g200kg/multiribbon/README.md

# multiribbon

## 開発中

現在開発中の謎楽器です。

複数のリボンコントローラーを並列に並べたフレットレスなギターのような演奏を想定しています。

MCU として XIAO RA4M1 を使用
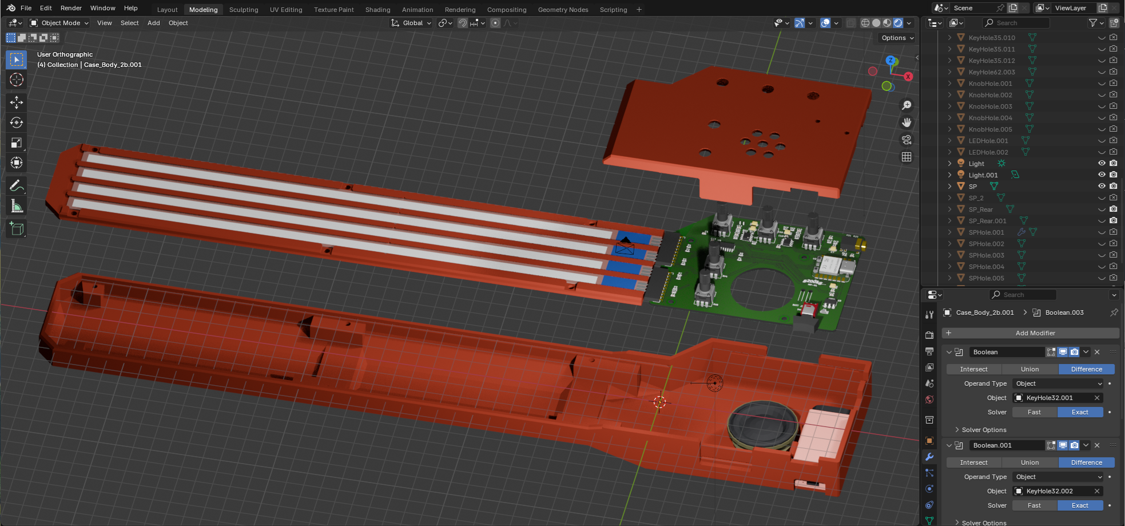
[picture p1: images/20250523_multiribbon_1.png]


## Demo
(https://www.youtube.com/watch?v=zGtmaKtH2Xs)
