g200kg/multiribbon/PCB/PCB-JLCPCB-BOM-Top.xlsx

Comment | Designator | Footprint | JLCPCB Part# | MFR.Part# | Qty
B5819W | D1 | D_SOD-123 | C8598 | B5819W SL | 1
0.1uF | C3,C6,C1,C15,C2,C5,C9,C13 | C_0603_1608Metric | C14663 | CC0603KRX7R9BB104 | 8
10K | R4,R6,R8,R10,R17,R16 | R_0603_1608Metric | C25804 | 0603WAF1002T5E | 6
220R | R3,R5,R7,R9,R20,R21,R18 | R_0603_1608Metric | C22962 | 0603WAF2200T5E | 7
4.7K | R13,R12,R15 | R_0603_1608Metric | C23162 | 0603WAF4701T5E | 3
BLM18AG121SN1D | FB2,FB1 | L_0603_1608Metric | C1002 | GZ1608D601TF | 2
220pF | C18,C17 | C_0603_1608Metric | C1603 | CL10B221KB8NNNC | 2
PAM8302AAD | U5 | SOIC-8_3.9x4.9mm_P1.27mm | C112137 | PAM8302AADCR | 1
10nF | C12 | C_0603_1608Metric | C57112 | 0603B103K500NT | 1
6.8K | R14 | R_0603_1608Metric | C23212 | 0603WAF6801T5E | 1
10uF | C11,C8,C7,C16,C14 | CP_EIA-3216-18_Kemet-A | C7171 | TAJA106K016RNJ | 5
20k | R11 | R_0603_1608Metric | C4184 | 0603WAF2002T5E | 1
2.2K | R2,R1 | R_0603_1608Metric | C4190 | 0603WAF2201T5E | 2
CD74HC4051M96 | U4 | SO-16_3.9x9.9mm_P1.27mm | C132065 | CD74HC4051M96 | 1
XKB_PJ-342B | J5 | Jack_3.5mm_XKB_PJ342B-TX | C388632 | PJ-342B-TX-SMT | 1
LM358DR2G | U1 | SOIC-8_3.9x4.9mm_P1.27mm | C7950 | LM358DR2G | 1
47K | R19,R22 | R_0603_1608Metric | C25819 | 0603WAF4702T5E | 2
2.2nF | C4,C10 | C_0603_1608Metric | C1604 | 0603B222K500NT | 2
AMS1117-5.0 | U3 | SOT-223-3_TabPin2 | C6187 | AMS1117-5.0 | 1
