g200kg/multiribbon/PCB/PCB_Keys/PCB_Keys-JLCPCB-BOM-Top.xlsx

Comment | Designator | Footprint | JLCPCB Part# | MFR.Part# | Qty
SW_Push | SW30,SW27,SW42,SW4,SW28,SW22,SW3,SW38,SW13,SW55,SW11,SW33,SW26,SW40,SW36,SW21,SW35,SW48,SW6,SW20,SW49,SW31,SW14,SW25,SW29,SW16,SW39,SW58,SW44,SW17,SW23,SW12,SW59,SW32,SW10,SW54,SW37,SW18,SW7,SW43,SW15,SW50,SW8,SW19,SW9,SW24,SW47,SW41,SW2,SW5,SW60,SW52,SW56,SW45,SW1,SW34,SW53,SW57,SW46,SW51 | Sw_Push_12x12_SMD | C36498966 | HX 12x12x7.3TPFT-B | 60
1K | R11,R49,R20,R19,R56,R9,R40,R51,R1,R7,R29,R23,R42,R41,R33,R44,R46,R24,R55,R37,R48,R3,R5,R38,R52,R13,R6,R32,R17,R14,R30,R34,R45,R2,R53,R12,R10,R31,R21,R8,R22,R47,R15,R27,R50,R18,R36,R26,R25,R28,R35,R39,R4,R43,R16,R54 | R_0603_1608Metric | C21190 | 0603WAF1001T5E | 56
10K | R58,R60,R59,R57,R65 | R_0603_1608Metric | C25804 | 0603WAF1002T5E | 5
220R | R64,R63,R61,R62 | R_0603_1608Metric | C22962 | 0603WAF2200T5E | 4
0.1uF | C2,C1 | C_0603_1608Metric | C14663 | CC0603KRX7R9BB104 | 2
MMA8452Q | U1 | QFN16_3x3mm_MMA8452Q | C11360 | MMA8452QR1 | 1
