g200kg/multiribbon/Blender/Case_2t.stl

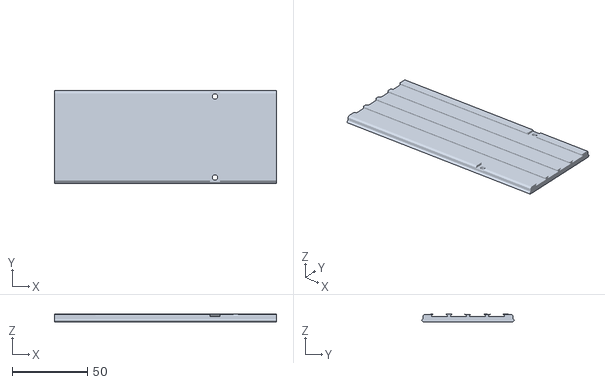
[picture p2: CAD file, 2025-05-23]
Blender/Case_2t.stl
148.0 x 62.0 x 5.00
