g200kg/multiribbon/Blender/Case_2m.stl

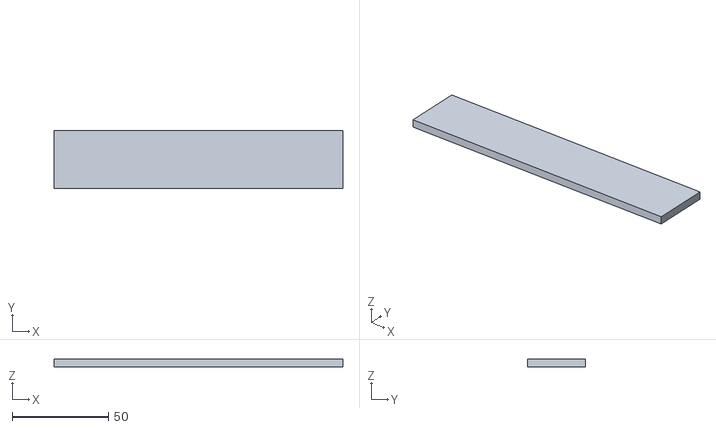
[picture p3: CAD file, 2025-05-23]
Blender/Case_2m.stl
150.0 x 30.0 x 4.00
