g200kg/multiribbon/Blender/Case_3t.stl

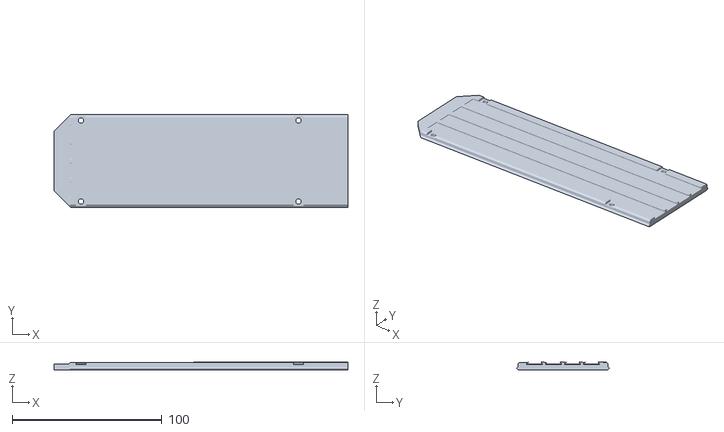
[picture p4: CAD file, 2025-05-23]
Blender/Case_3t.stl
196.0 x 62.0 x 5.00
