g200kg/multiribbon/Blender/Case_1b.stl

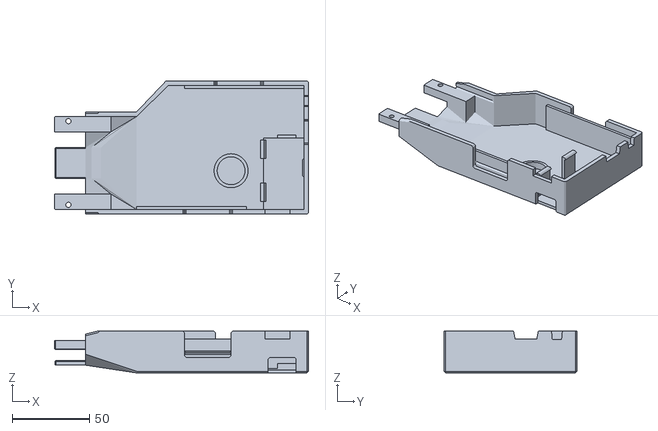
[picture p5: CAD file, 2025-05-23]
Blender/Case_1b.stl
164.0 x 86.0 x 27.0
