g200kg/multiribbon/Blender/Case_2b.stl

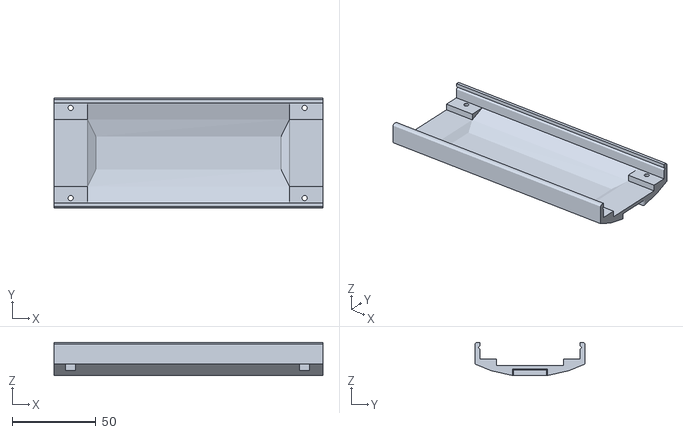
[picture p6: CAD file, 2025-05-18]
Blender/Case_2b.stl
161.0 x 66.0 x 20.0
