g200kg/multiribbon/Blender/Case_1t.stl

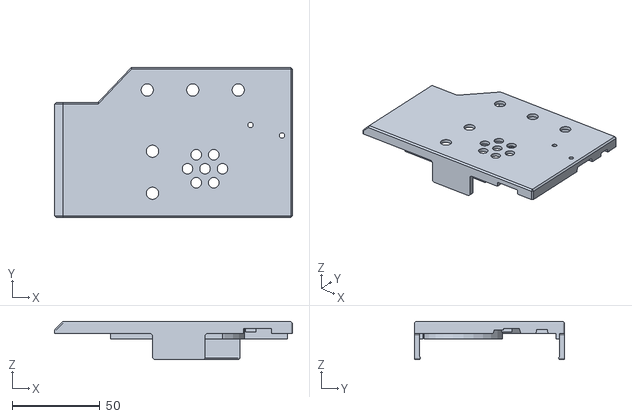
[picture p7: CAD file, 2025-05-18]
Blender/Case_1t.stl
136.0 x 86.0 x 22.0
