g200kg/multiribbon/Blender/Case_3b.stl

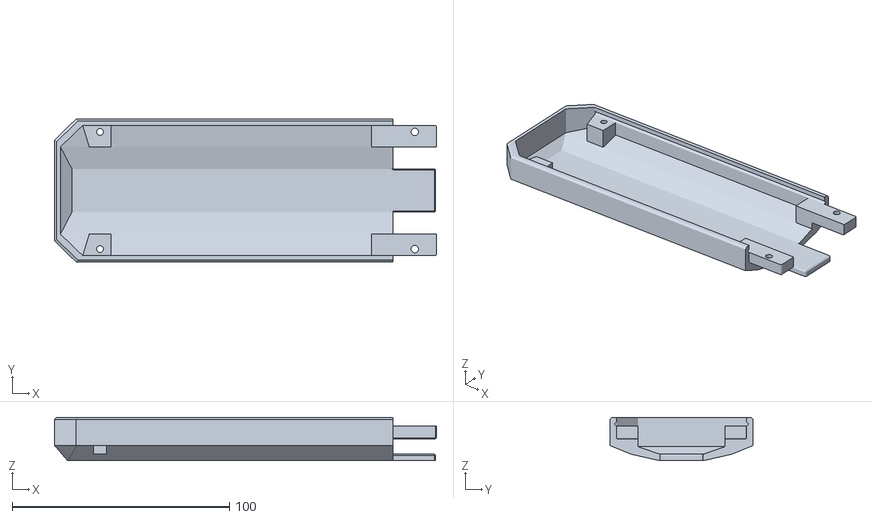
[picture p8: CAD file, 2025-05-18]
Blender/Case_3b.stl
176.0 x 66.0 x 20.0
