g200kg/multiribbon/Docs/XIAO-RA4M1_SCH_PDF_v1.0_240719.pdf

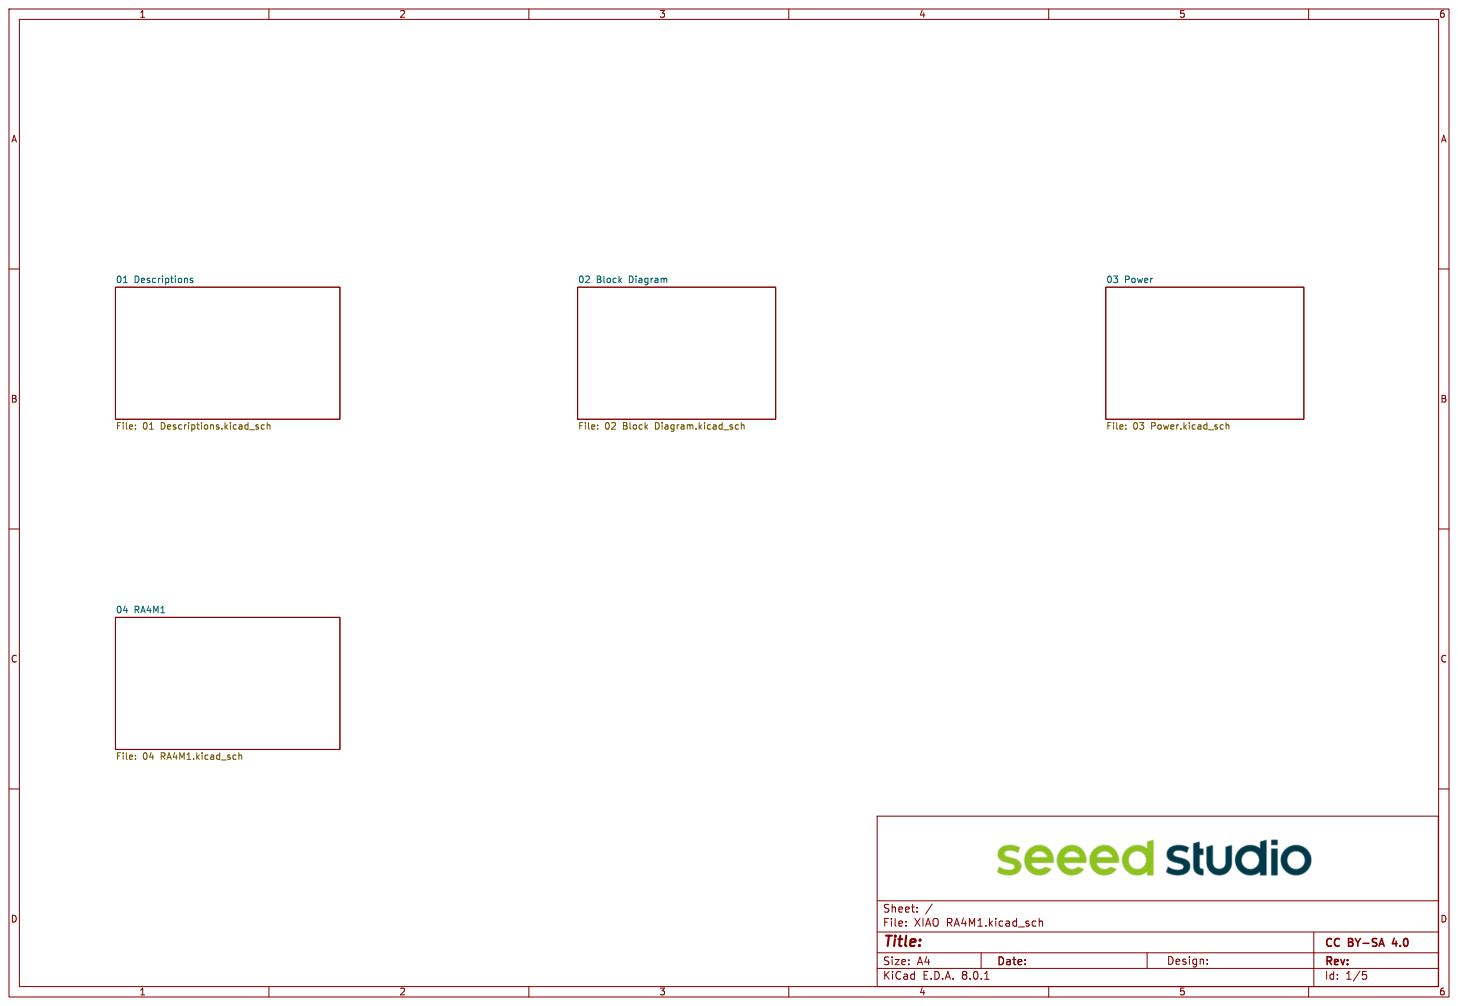
[picture p9: page 1]

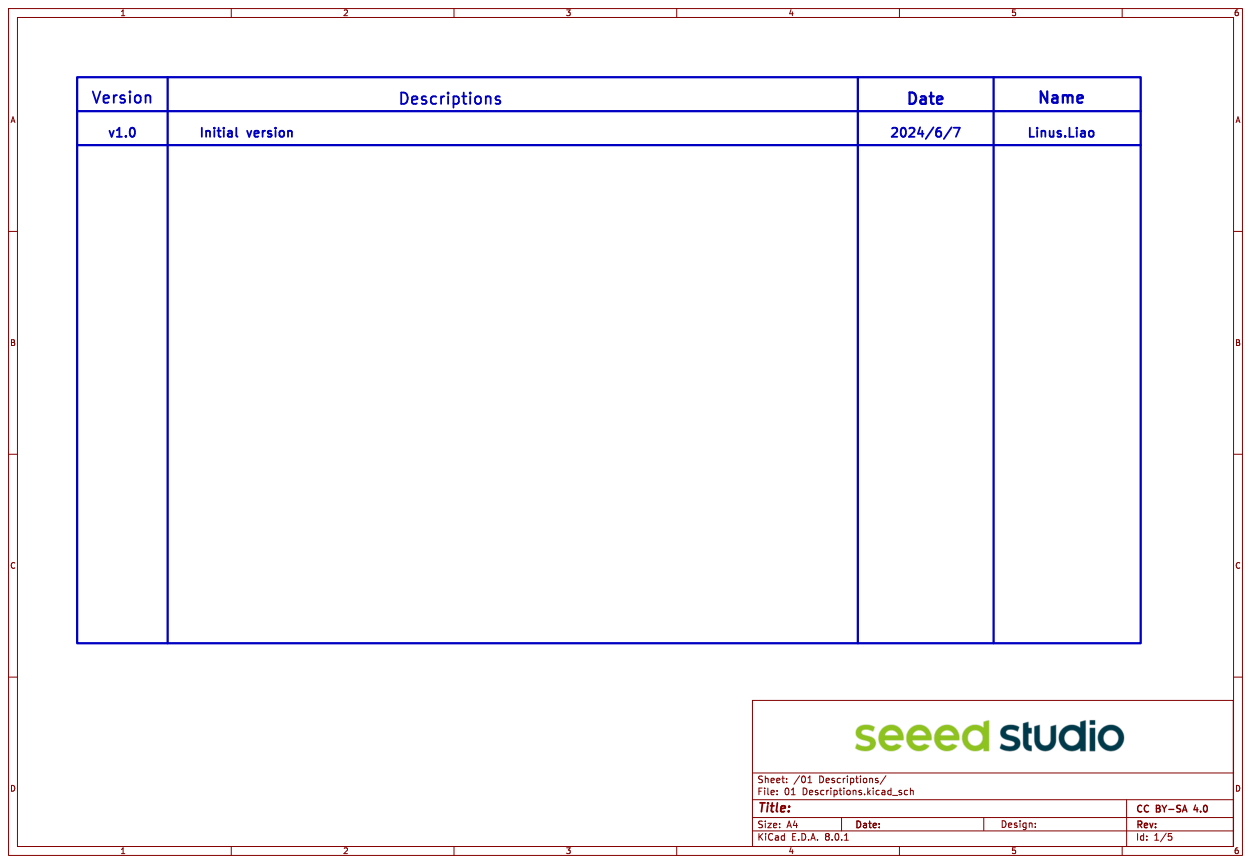
[picture p10: page 2]

Name

2024/6/7 | Linus.Liao

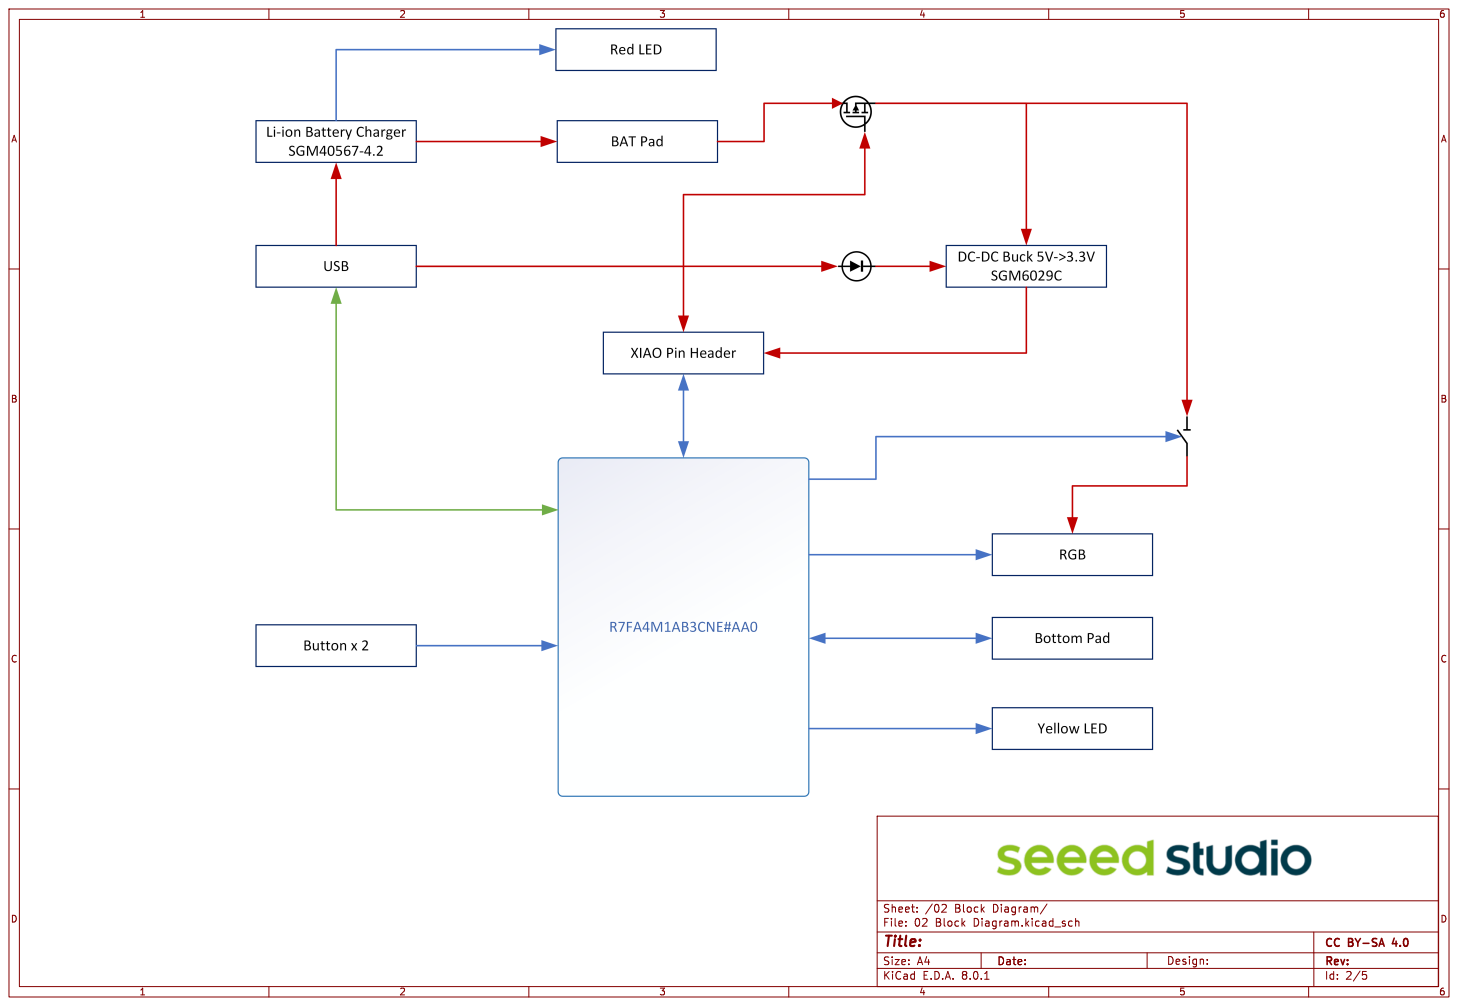
[picture p11: page 3]

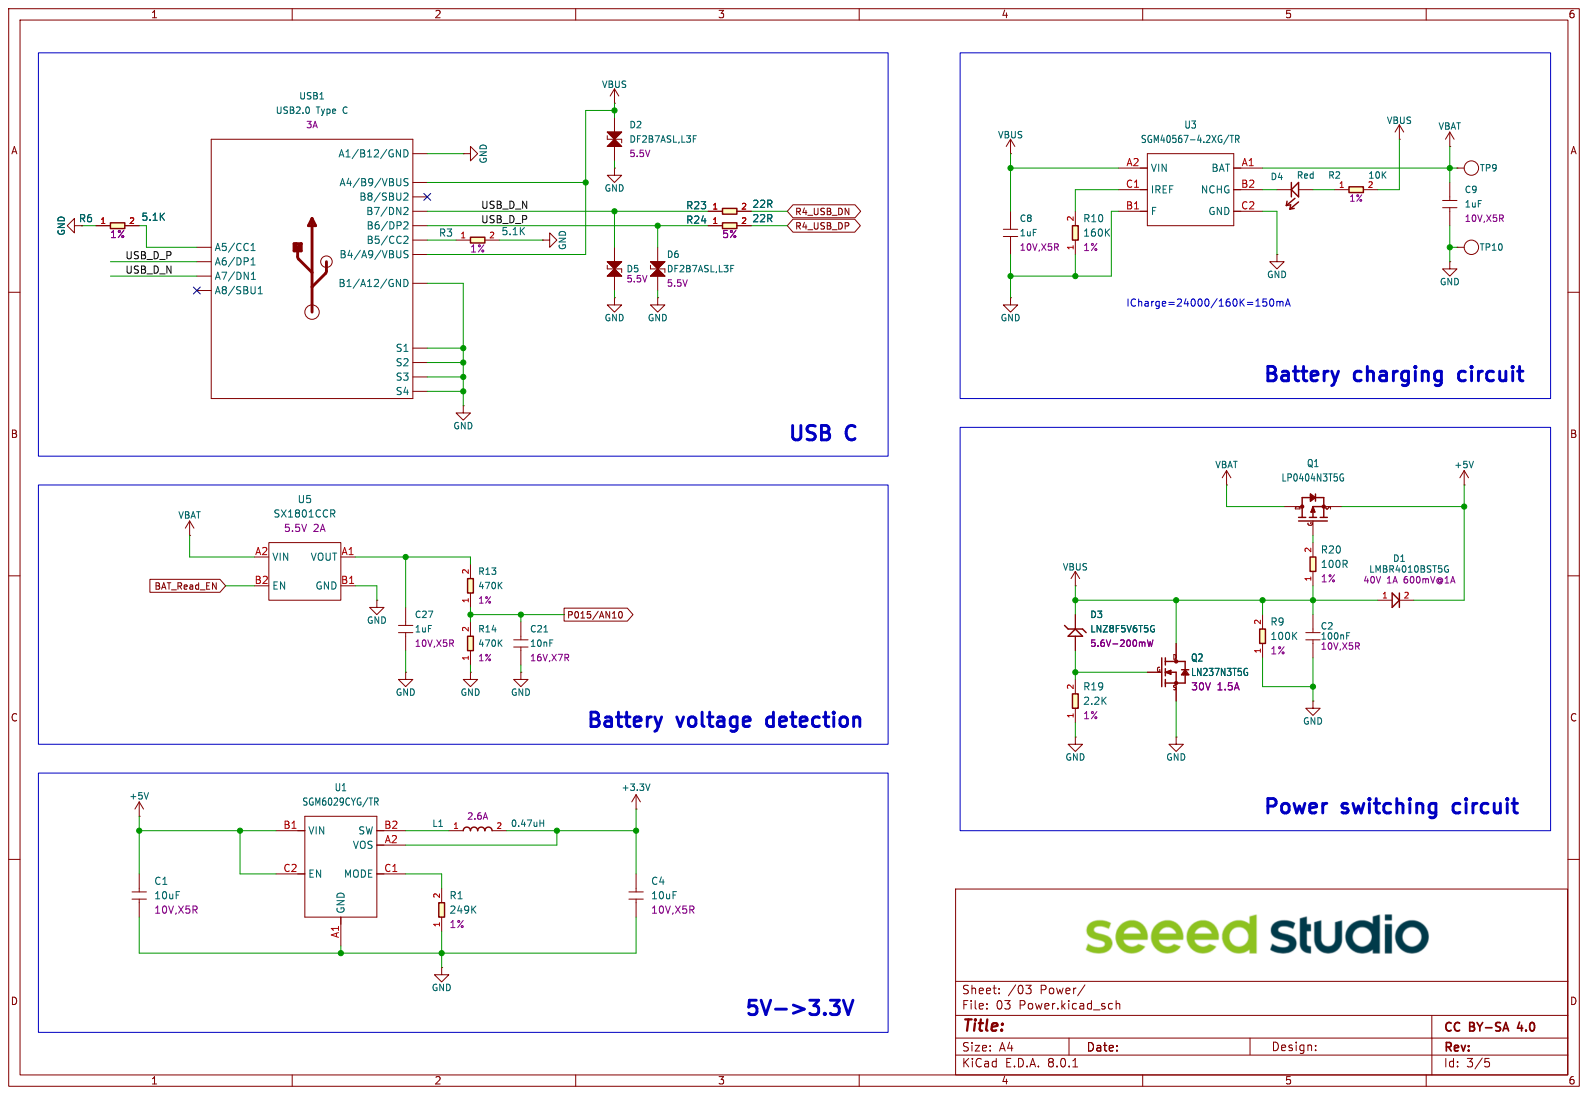
[picture p12: page 4]

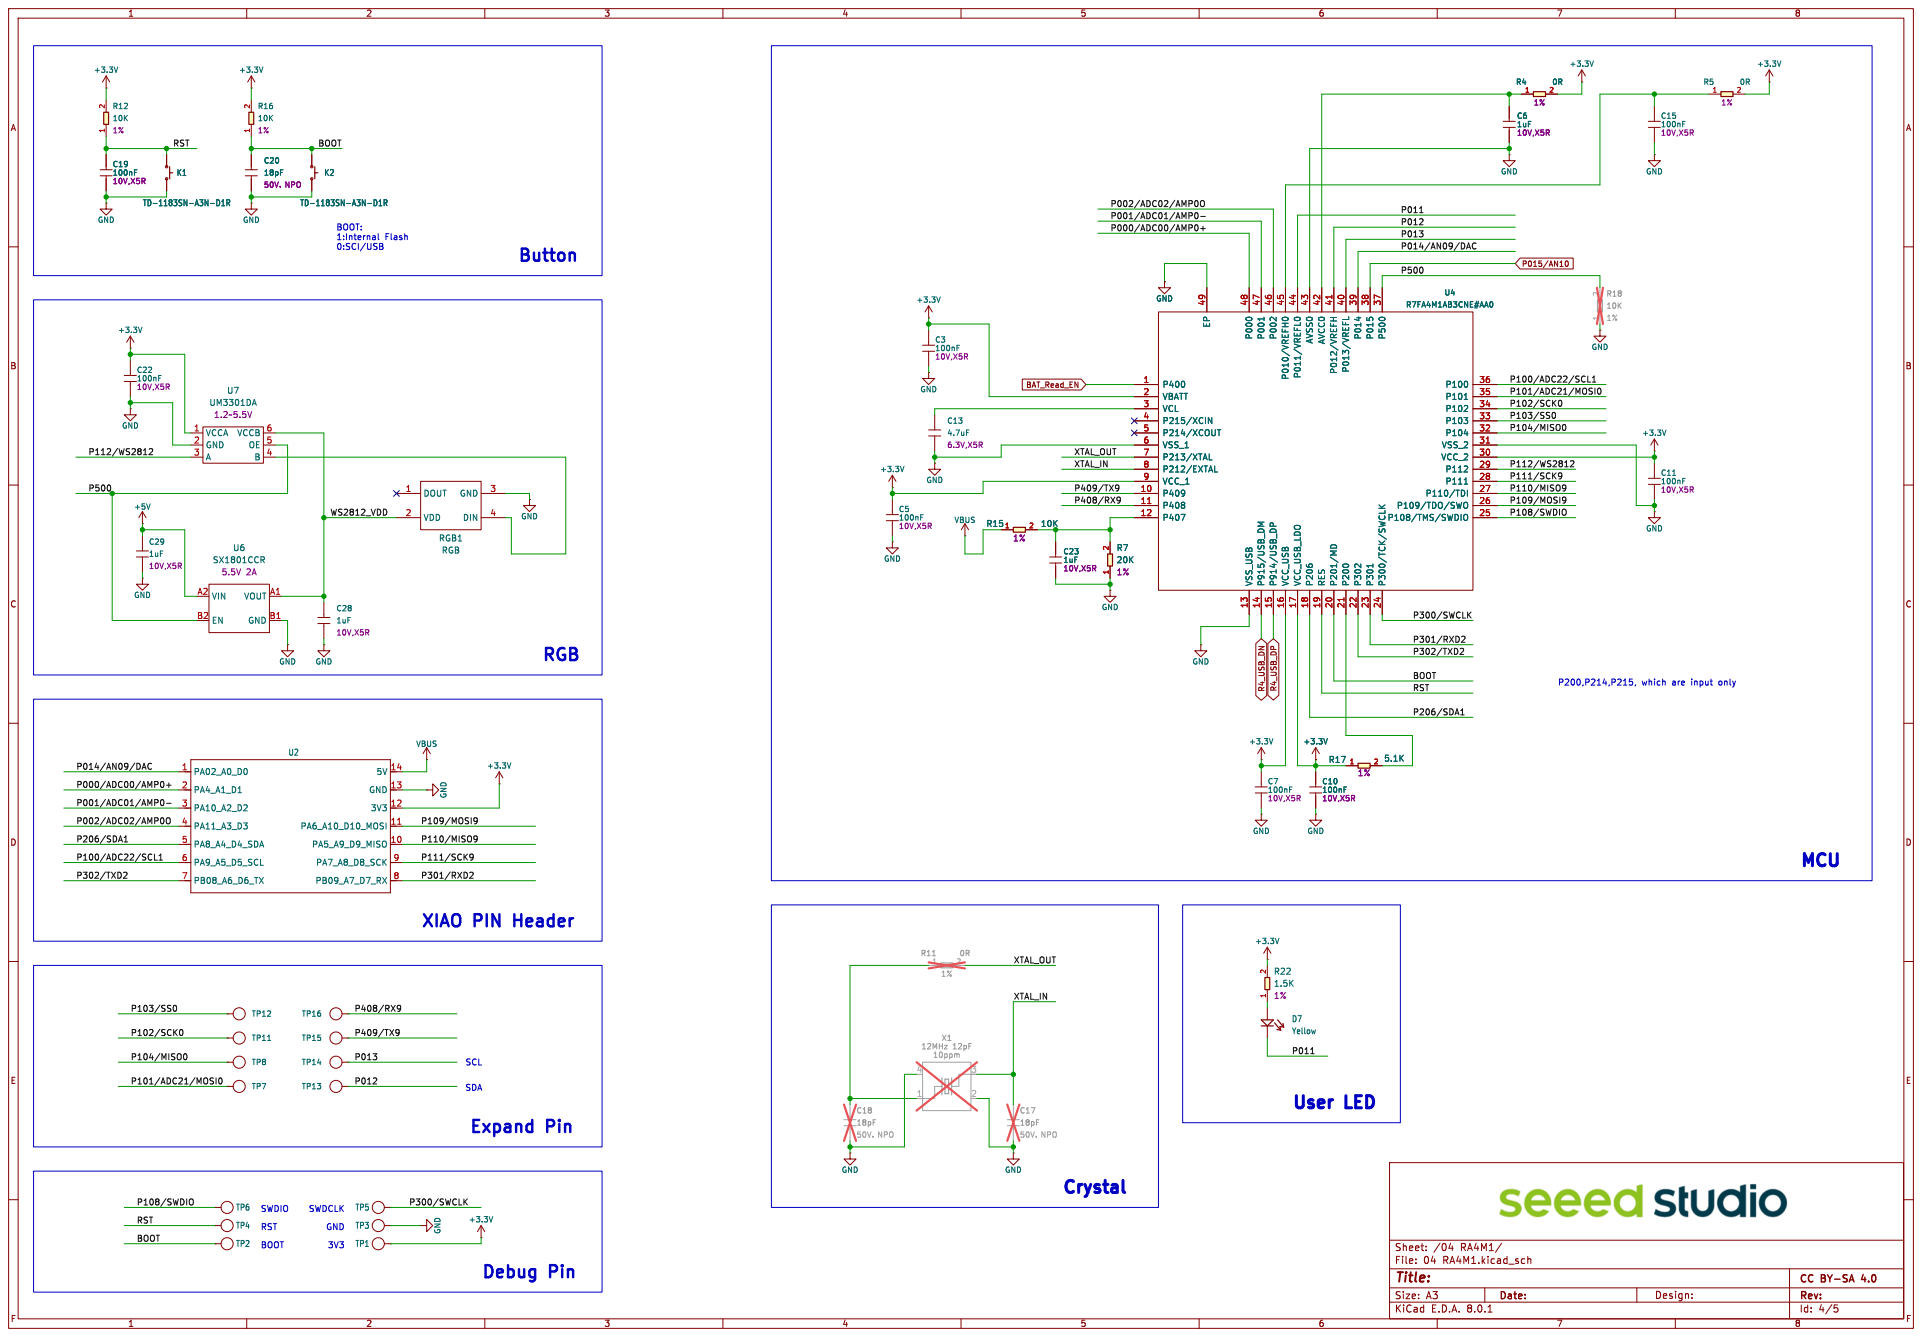
[picture p13: page 5]

2 U4 R7FA4M1AB3CNE#AA0 P400 1 P409 10 P408 11 P407 12 VSS_USB 13 P915/USB_DM 14 P914/USB_DP 15 VCC_USB 16 VCC_USB_LDO 17 P206 18 RES 19 VBATT 2 P201/MD 20 P200 21 P302 22 P301 23 P300/TCK/SWCLK 24 P108/TMS/SWDIO 25 P109/TDO/SWO 26 P110/TDI 27 P111 28 P112 29 VCL 3 VCC_2 30 VSS_2 31 P104 32 P103 33 P102 34 P101 35 P100 36 P500 37 P015 38 P014 39 P215/XCIN 4 P013/VREFL 40 P012/VREFH 41 AVCC0 42 AVSS0 43 P011/VREFL0 44 P010/VREFH0 45 P002 46 P001 47 P000 48 EP 49 P214/XCOUT 5 VSS_1 6 P213/XTAL 7 P212/EXTAL 8 VCC_1 9 R17 5.1K
