g200kg/multiribbon/PCB/PCB.kicad_pcb

## KiCad design PCB/PCB.kicad_pcb (2025-05-23)

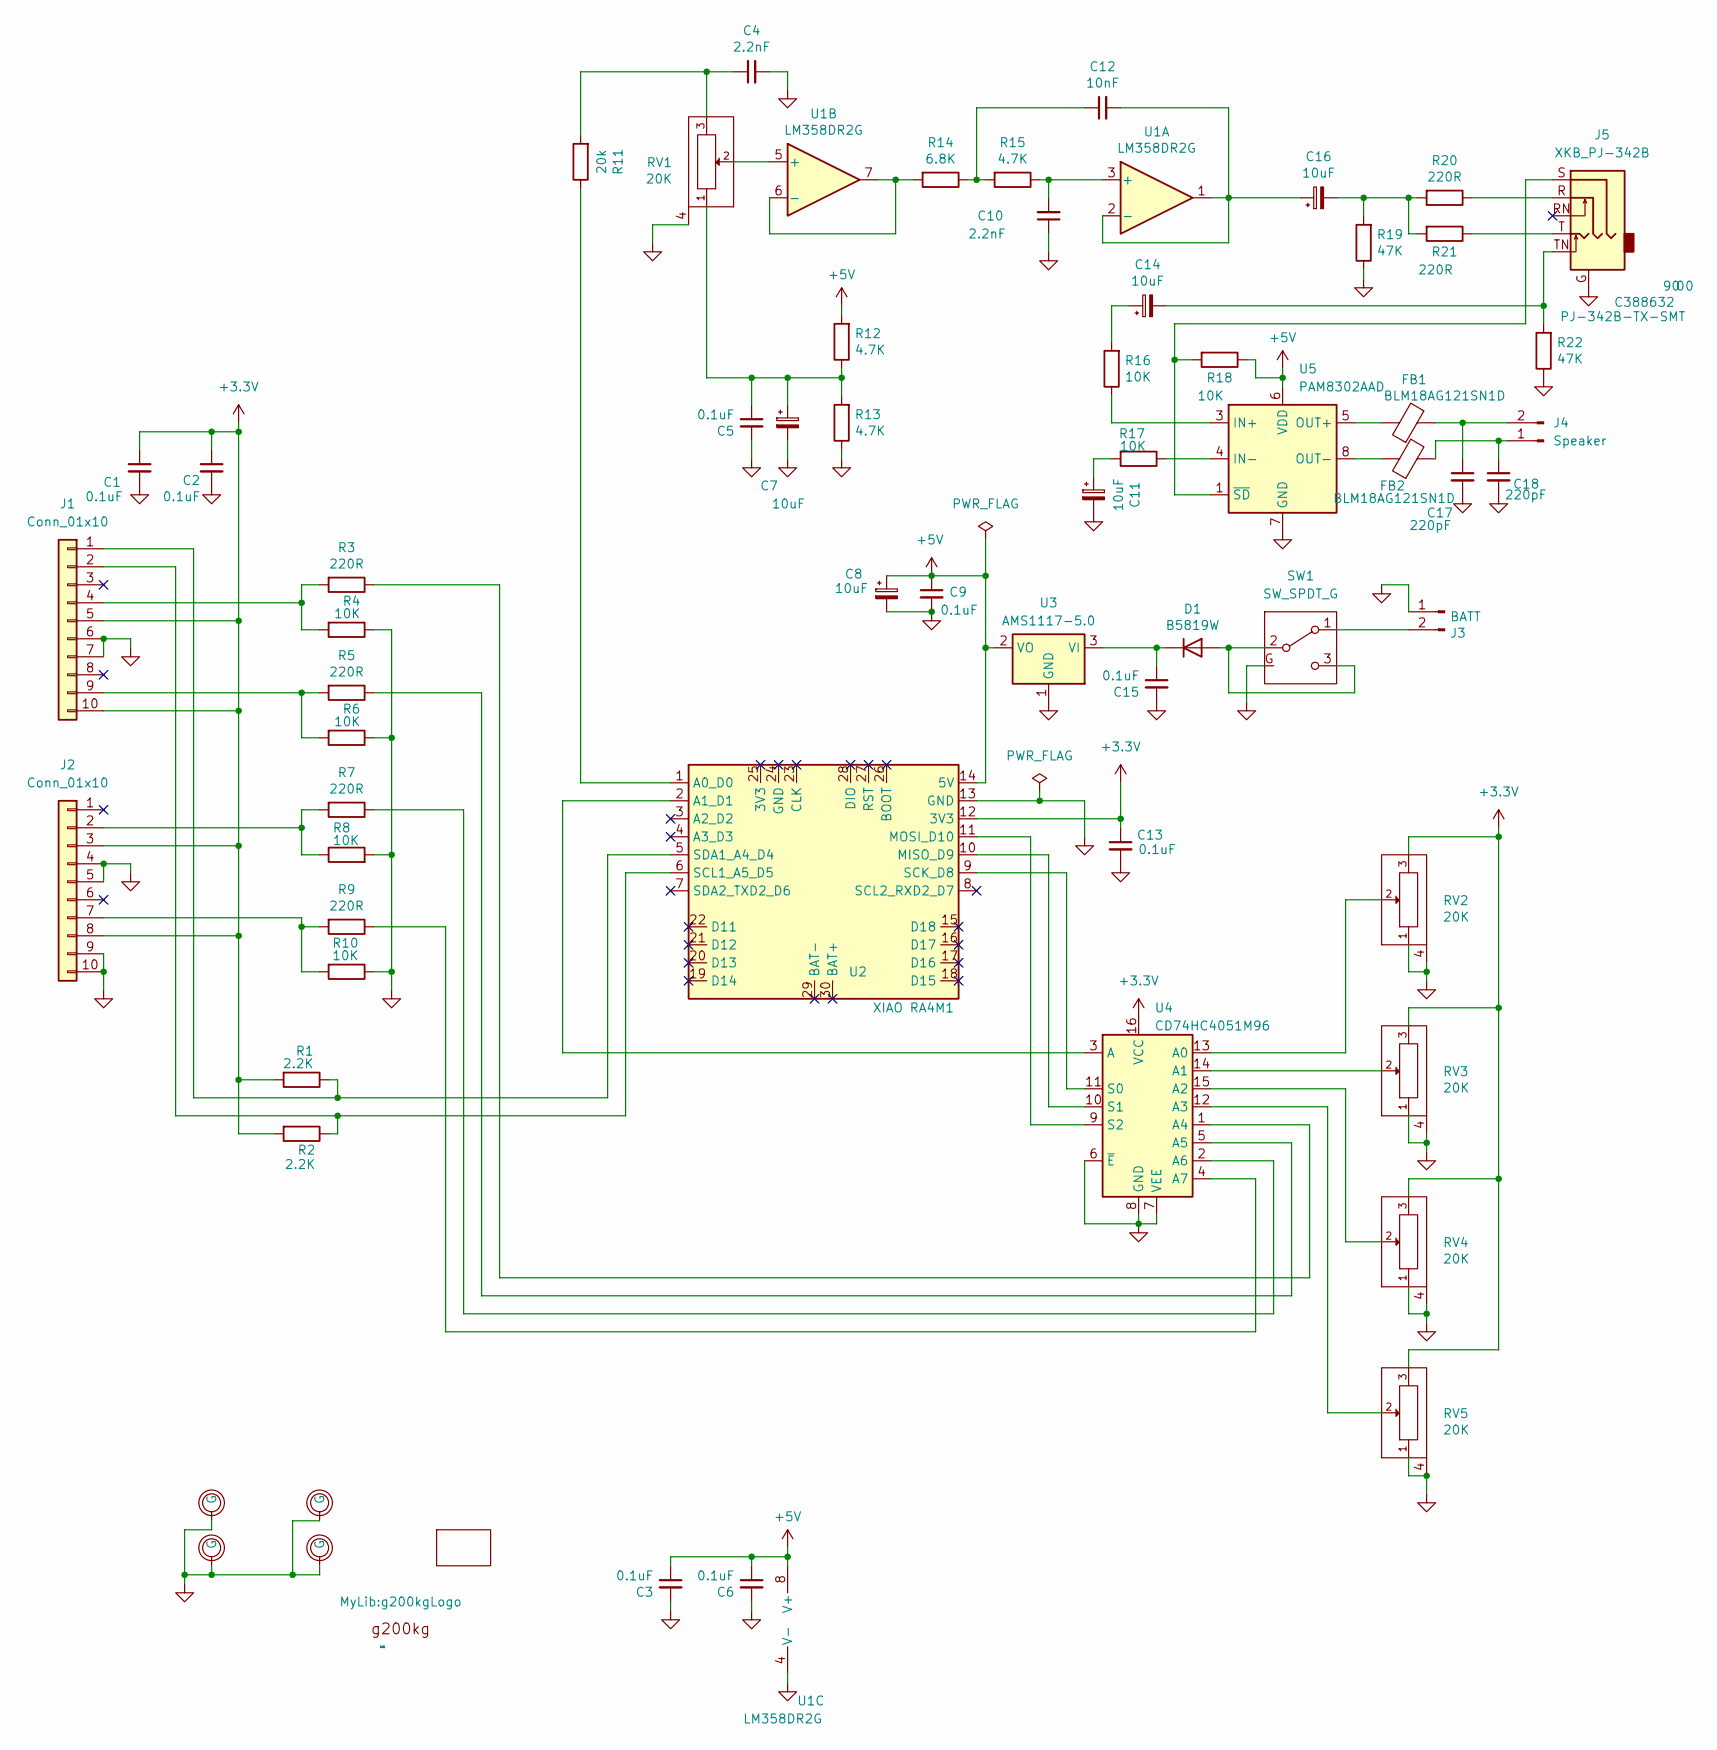
[picture p14: schematic PCB.kicad_sch]

Parts:
C1, C2, C3, C5, C6, C9, C13, C15: 0.1uF; C_0603_1608Metric
C4, C10: 2.2nF; C_0603_1608Metric
C7, C8, C11, C14, C16: 10uF; CP_EIA-3216-18_Kemet-A
C12: 10nF; C_0603_1608Metric
C17, C18: 220pF; C_0603_1608Metric
D1: B5819W; D_SOD-123
FB1, FB2: BLM18AG121SN1D; L_0603_1608Metric; LCSC GZ1608D601TF
H1, H2, H3, H4: Hole; MountingHole_3.2mm_M3_DIN965_Pad
J1, J2: Conn_01x10; PinSocket_1x10_P2.54mm_Horizontal
J3: BATT; SolderWire-0.25sqmm_1x02_P4.2mm_D0.65mm_OD1.7mm_Relief
J4: Speaker; JST_PH_S2B-PH-K_1x02_P2.00mm_Horizontal
J5: XKB_PJ-342B; Jack_3.5mm_XKB_PJ342B-TX; LCSC C388632
LG1: LOGO; g200kgLogo
M1: ModuleNC; 006P
R1, R2: 2.2K; R_0603_1608Metric
R3, R5, R7, R9, R20, R21: 220R; R_0603_1608Metric
R4, R6, R8, R10, R16, R17, R18: 10K; R_0603_1608Metric
R11: 20k; R_0603_1608Metric
R12, R13, R15: 4.7K; R_0603_1608Metric
R14: 6.8K; R_0603_1608Metric
R19, R22: 47K; R_0603_1608Metric
RV1, RV2, RV3, RV4, RV5: 20K; Potentiometer_Alps_RK09K_Single_Vertical
SW1: SW_SPDT_G; Sw_Rocker_4MS1R202M6QES
U1: LM358DR2G; SOIC-8_3.9x4.9mm_P1.27mm; LCSC C7950
U2: XIAO RA4M1; XIAO-RA4M1-SMD
U3: AMS1117-5.0; SOT-223-3_TabPin2
U4: CD74HC4051M96; SO-16_3.9x9.9mm_P1.27mm
U5: PAM8302AAD; SOIC-8_3.9x4.9mm_P1.27mm

Connections:
+3.3V: C1.1, C2.1, C13.1, J1.5, J1.10, J2.3, J2.8, R1.2, R2.2, RV2.3, RV3.3, RV4.3, RV5.3, U2.12 (3V3), U4.16 (VCC)
+5V: C3.1, C6.1, C8.1, C9.1, R12.2, R18.1, U1.8 (V+), U2.14 (5V), U3.2 (VO), U5.6 (VDD)
GNDD: C1.2, C2.2, C3.2, C4.2, C5.2, C6.2, C7.2, C8.2, C9.2, C10.1, C11.2, C13.2, C15.2, C17.2, C18.2, H1.1 (G), H2.1 (G), H3.1 (G), H4.1 (G), J1.6, J1.7, J2.4, J2.5, J2.9, J2.10, J3.1, J5.G, R4.1, R6.1, R8.2, R10.1, R13.1, R19.1, R22.1, RV1.4 (G), RV2.1, RV2.4 (G), RV3.1, RV3.4 (G), RV4.1, RV4.4 (G), RV5.1, RV5.4 (G), SW1.G, U1.4 (V-), U2.13 (GND), U3.1 (GND), U4.6 (~E), U4.7 (VEE), U4.8 (GND), U5.7 (GND)
unnamed: C4.1, R11.2, RV1.3
unnamed: C5.1, C7.1, R12.1, R13.2, RV1.1
unnamed: C11.1, R17.2
unnamed: C12.1, R14.1, R15.2
unnamed: C14.1, R16.2
unnamed: C14.2, J5.TN, R22.2
unnamed: C16.2, R19.2, R20.2, R21.2
unnamed: D1.2 (A), SW1.2 (B), SW1.3 (C)
unnamed: C15.1, D1.1 (K), U3.3 (VI)
unnamed: J1.1, R1.1, U2.5 (SDA1_A4_D4)
unnamed: J1.2, R2.1, U2.6 (SCL1_A5_D5)
unnamed: J1.4, R3.2, R4.2
unnamed: J1.9, R5.2, R6.2
unnamed: J2.2, R7.2, R8.1
unnamed: J2.7, R9.2, R10.2
unnamed: J3.2, SW1.1 (A)
unnamed: C18.1, FB2.2, J4.1
unnamed: C17.1, FB1.2, J4.2
unnamed: J5.R, R20.1
unnamed: J5.T, R21.1
unnamed: C10.2, R15.1, U1.3 (+)
unnamed: C12.2, C16.1, U1.1, U1.2 (-)
unnamed: RV1.2, U1.5 (+)
unnamed: R14.2, U1.6 (-), U1.7
unnamed: R11.1, U2.1 (A0_D0)
unnamed: U2.2 (A1_D1), U4.3 (A)
unnamed: U2.10 (MISO_D9), U4.10 (S1)
unnamed: U2.11 (MOSI_D10), U4.9 (S2)
unnamed: U2.9 (SCK_D8), U4.11 (S0)
unnamed: RV2.2, U4.13 (A0)
unnamed: RV3.2, U4.14 (A1)
unnamed: RV4.2, U4.15 (A2)
unnamed: RV5.2, U4.12 (A3)
unnamed: R3.1, U4.1 (A4)
unnamed: R5.1, U4.5 (A5)
unnamed: R7.1, U4.2 (A6)
unnamed: R9.1, U4.4 (A7)
unnamed: R16.1, U5.3 (IN+)
unnamed: R17.1, U5.4 (IN-)
unnamed: FB1.1, U5.5 (OUT+)
unnamed: FB2.1, U5.8 (OUT-)
unnamed: J5.S, R18.2, U5.1 (~SD)

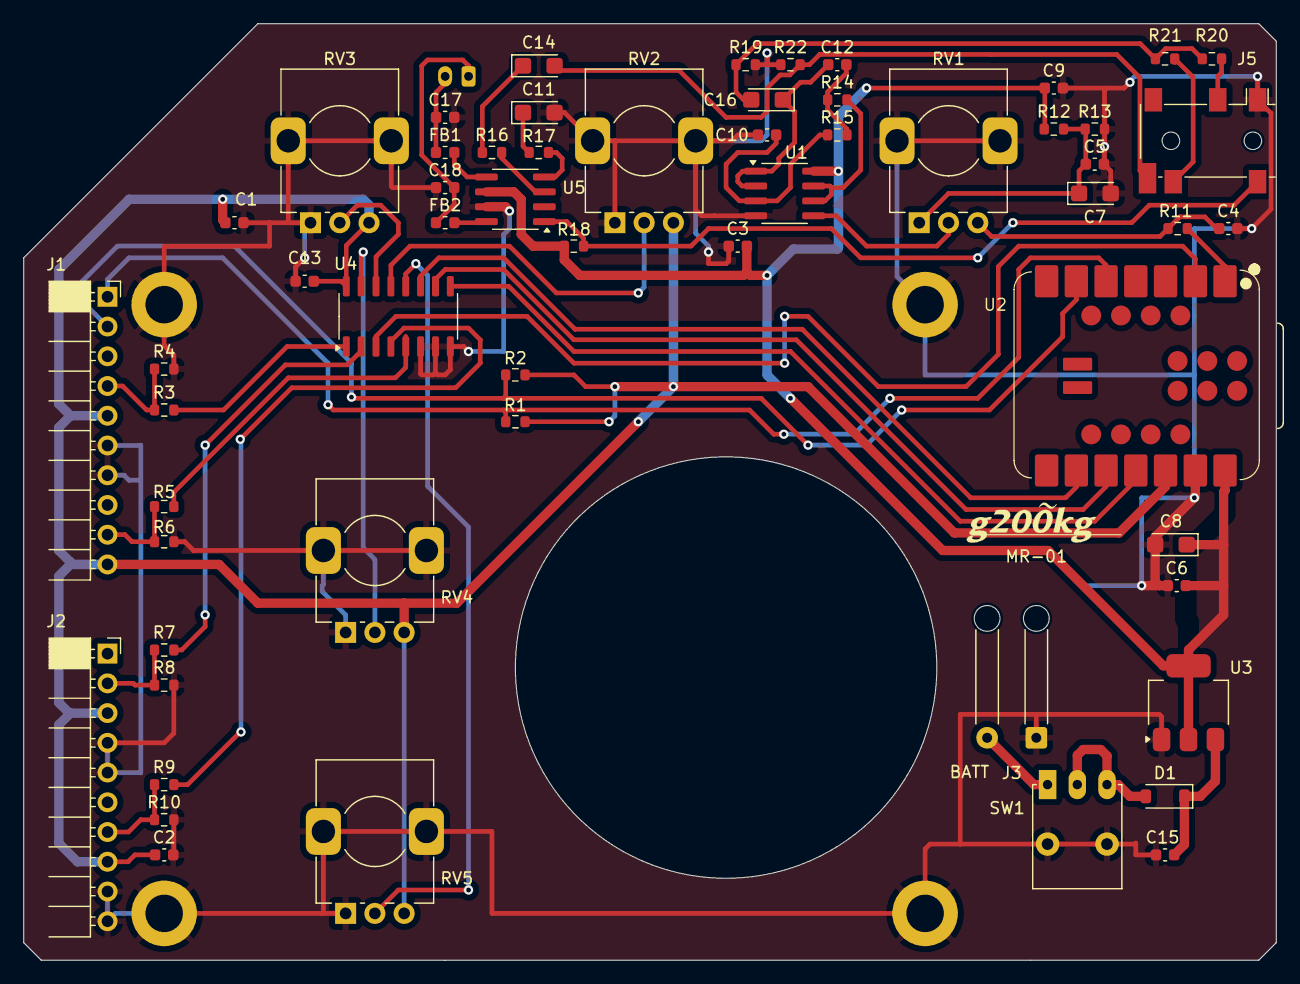
[picture p15: board PCB.kicad_pcb from above]

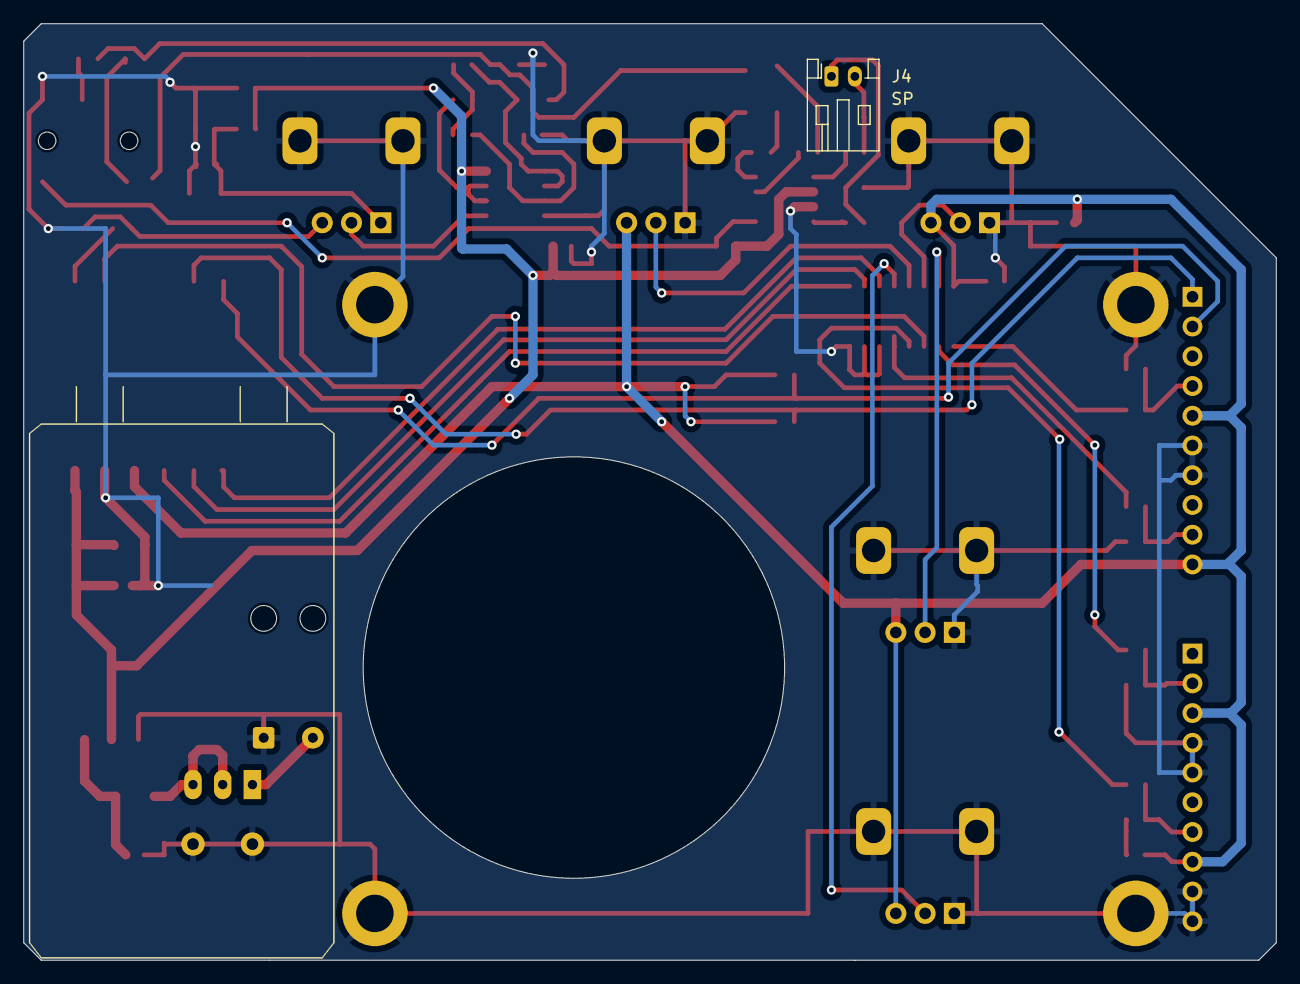
[picture p16: board PCB.kicad_pcb from below]

Board: 2 copper layers, 107.0 x 80.0 mm, 65 parts (2 on the bottom side), 45 nets.
