g200kg/multiribbon/PCB/PCB_Keys/PCB_Keys.kicad_pcb

## KiCad design PCB/PCB_Keys/PCB_Keys.kicad_pcb (2025-05-18)

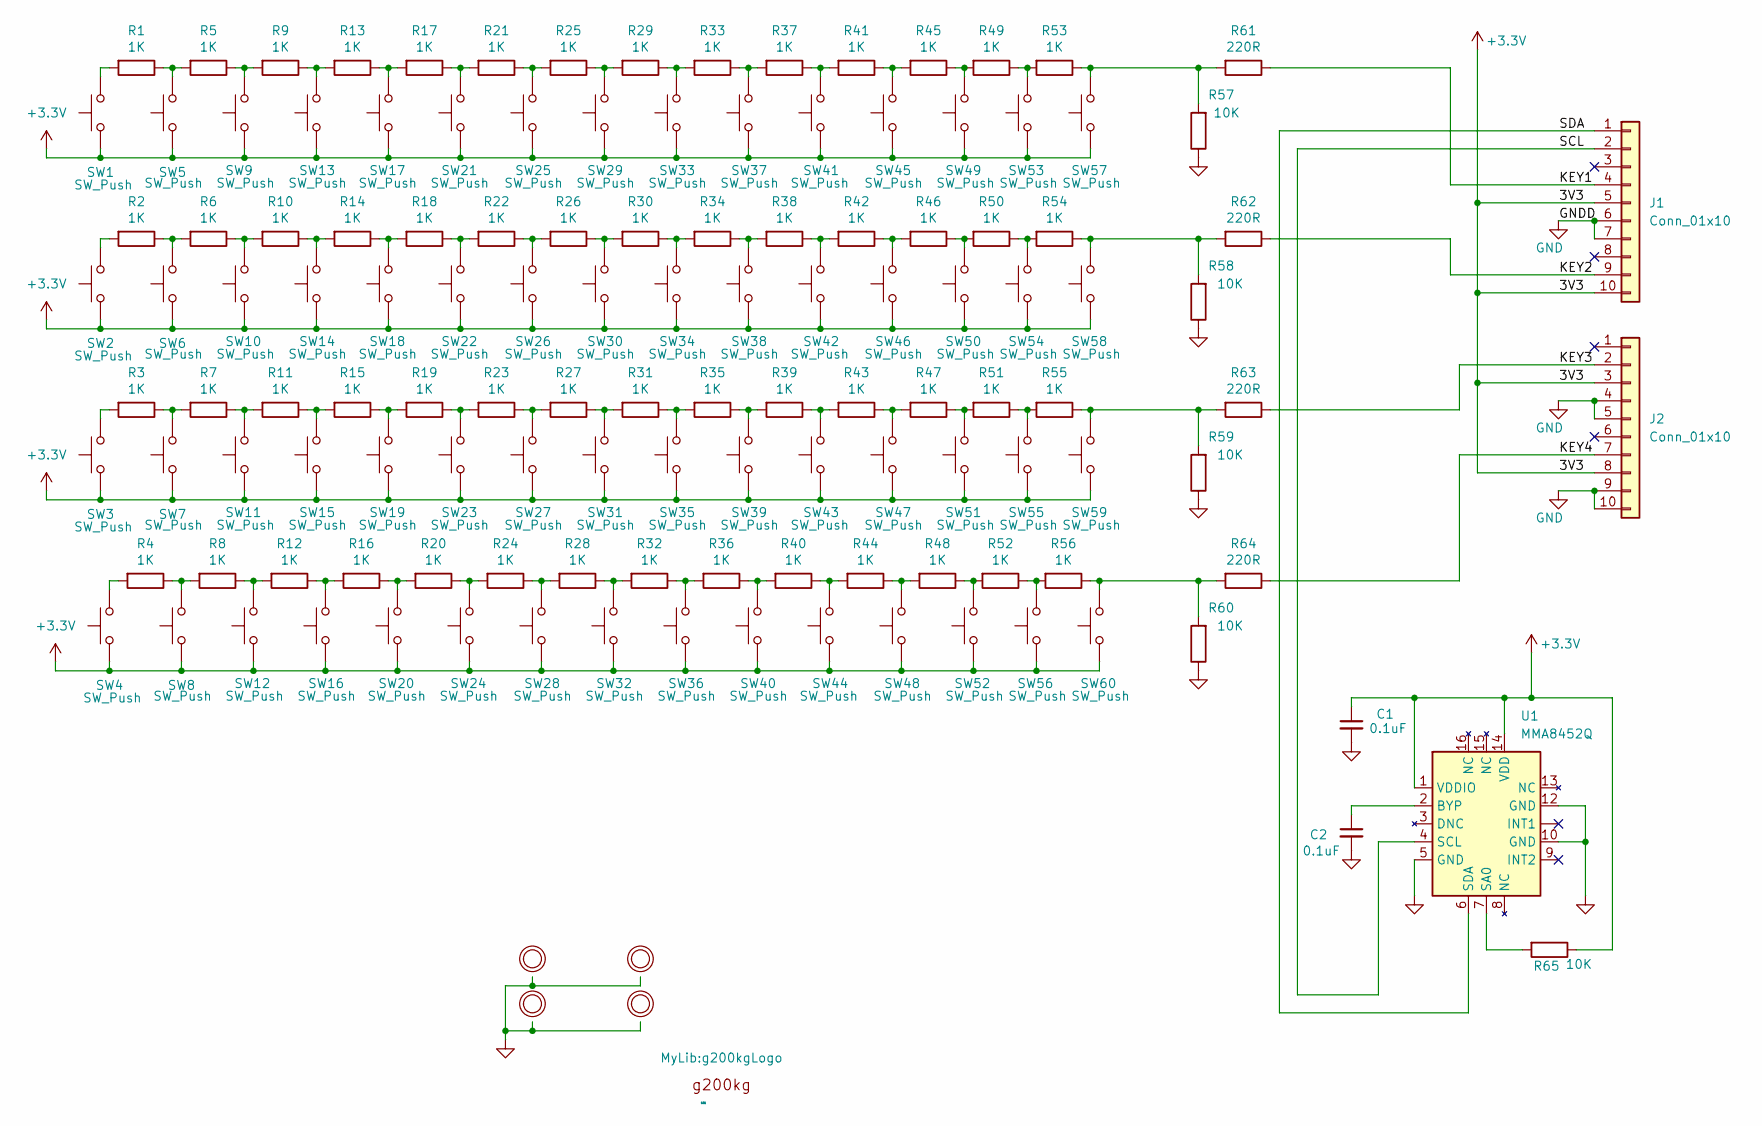
[picture p17: schematic PCB_Keys.kicad_sch]

Parts:
C1, C2: 0.1uF; C_0603_1608Metric
H1, H2, H3, H4: Hole; MountingHole_3.2mm_M3_DIN965_Pad
J1, J2: Conn_01x10; PinHeader_1x10_P2.54mm_Horizontal
LG1: LOGO; g200kgLogo
R1, R2, R3, R4, R5, R6, R7, R8, R9, R10, R11, R12, R13, R14, R15, R16, R17, R18, R19, R20, R21, R22, R23, R24, R25, R26, R27, R28, R29, R30, R31, R32, R33, R34, R35, R36, R37, R38, R39, R40, R41, R42, R43, R44, R45, R46, R47, R48, R49, R50, R51, R52, R53, R54, R55, R56: 1K; R_0603_1608Metric
R57, R58, R59, R60, R65: 10K; R_0603_1608Metric
R61, R62, R63, R64: 220R; R_0603_1608Metric
SW1, SW2, SW3, SW4, SW5, SW6, SW7, SW8, SW9, SW10, SW11, SW12, SW13, SW14, SW15, SW16, SW17, SW18, SW19, SW20, SW21, SW22, SW23, SW24, SW25, SW26, SW27, SW28, SW29, SW30, SW31, SW32, SW33, SW34, SW35, SW36, SW37, SW38, SW39, SW40, SW41, SW42, SW43, SW44, SW45, SW46, SW47, SW48, SW49, SW50, SW51, SW52, SW53, SW54, SW55, SW56, SW57, SW58, SW59, SW60: SW_Push; Sw_Push_12x12_SMD
U1: MMA8452Q; QFN16_3x3mm_MMA8452Q

Connections:
+3.3V: C1.1, J1.5, J1.10, J2.3, J2.8, R65.1, SW1.1, SW2.1, SW3.1, SW4.1, SW5.1, SW6.1, SW7.1, SW8.1, SW9.1, SW10.1, SW11.1, SW12.1, SW13.1, SW14.1, SW15.1, SW16.1, SW17.1, SW18.1, SW19.1, SW20.1, SW21.1, SW22.1, SW23.1, SW24.1, SW25.1, SW26.1, SW27.1, SW28.1, SW29.1, SW30.1, SW31.1, SW32.1, SW33.1, SW34.1, SW35.1, SW36.1, SW37.1, SW38.1, SW39.1, SW40.1, SW41.1, SW42.1, SW43.1, SW44.1, SW45.1, SW46.1, SW47.1, SW48.1, SW49.1, SW50.1, SW51.1, SW52.1, SW53.1, SW54.1, SW55.1, SW56.1, SW57.1, SW58.1, SW59.1, SW60.1, U1.1 (VDDIO), U1.14 (VDD)
/KEY1: J1.4, R61.1
/KEY2: J1.9, R62.1
/KEY3: J2.2, R63.1
/KEY4: J2.7, R64.1
/SCL: J1.2, U1.4 (SCL)
/SDA: J1.1, U1.6 (SDA)
GND: C1.2, C2.2, H1.1 (G), H2.1 (G), H3.1 (G), H4.1 (G), J1.6, J1.7, J2.4, J2.5, J2.9, J2.10, R57.1, R58.1, R59.1, R60.1, U1.5 (GND), U1.10 (GND), U1.12 (GND)
unnamed: R1.1, R5.2, SW5.2
unnamed: R1.2, SW1.2
unnamed: R2.1, R6.2, SW6.2
unnamed: R2.2, SW2.2
unnamed: R3.1, R7.2, SW7.2
unnamed: R3.2, SW3.2
unnamed: R4.1, R8.2, SW8.2
unnamed: R4.2, SW4.2
unnamed: R5.1, R9.2, SW9.2
unnamed: R10.1, R14.2, SW14.2
unnamed: R6.1, R10.2, SW10.2
unnamed: R11.1, R15.2, SW15.2
unnamed: R7.1, R11.2, SW11.2
unnamed: R12.1, R16.2, SW16.2
unnamed: R8.1, R12.2, SW12.2
unnamed: R13.1, R17.2, SW17.2
unnamed: R9.1, R13.2, SW13.2
unnamed: R14.1, R18.2, SW18.2
unnamed: R15.1, R19.2, SW19.2
unnamed: R16.1, R20.2, SW20.2
unnamed: R17.1, R21.2, SW21.2
unnamed: R18.1, R22.2, SW22.2
unnamed: R19.1, R23.2, SW23.2
unnamed: R20.1, R24.2, SW24.2
unnamed: R21.1, R25.2, SW25.2
unnamed: R22.1, R26.2, SW26.2
unnamed: R23.1, R27.2, SW27.2
unnamed: R24.1, R28.2, SW28.2
unnamed: R25.1, R29.2, SW29.2
unnamed: R26.1, R30.2, SW30.2
unnamed: R27.1, R31.2, SW31.2
unnamed: R28.1, R32.2, SW32.2
unnamed: R29.1, R33.2, SW33.2
unnamed: R30.1, R34.2, SW34.2
unnamed: R31.1, R35.2, SW35.2
unnamed: R32.1, R36.2, SW36.2
unnamed: R33.1, R37.2, SW37.2
unnamed: R34.1, R38.2, SW38.2
unnamed: R35.1, R39.2, SW39.2
unnamed: R36.1, R40.2, SW40.2
unnamed: R37.1, R41.2, SW41.2
unnamed: R38.1, R42.2, SW42.2
unnamed: R39.1, R43.2, SW43.2
unnamed: R40.1, R44.2, SW44.2
unnamed: R41.1, R45.2, SW45.2
unnamed: R42.1, R46.2, SW46.2
unnamed: R43.1, R47.2, SW47.2
unnamed: R44.1, R48.2, SW48.2
unnamed: R45.1, R49.2, SW49.2
unnamed: R46.1, R50.2, SW50.2
unnamed: R47.1, R51.2, SW51.2
unnamed: R48.1, R52.2, SW52.2
unnamed: R49.1, R53.2, SW53.2
unnamed: R50.1, R54.2, SW54.2
unnamed: R51.1, R55.2, SW55.2
unnamed: R52.1, R56.2, SW56.2
unnamed: R53.1, R57.2, R61.2, SW57.2
unnamed: R54.1, R58.2, R62.2, SW58.2
unnamed: R55.1, R59.2, R63.2, SW59.2
unnamed: R56.1, R60.2, R64.2, SW60.2
unnamed: C2.1, U1.2 (BYP)
unnamed: R65.2, U1.7 (SA0)

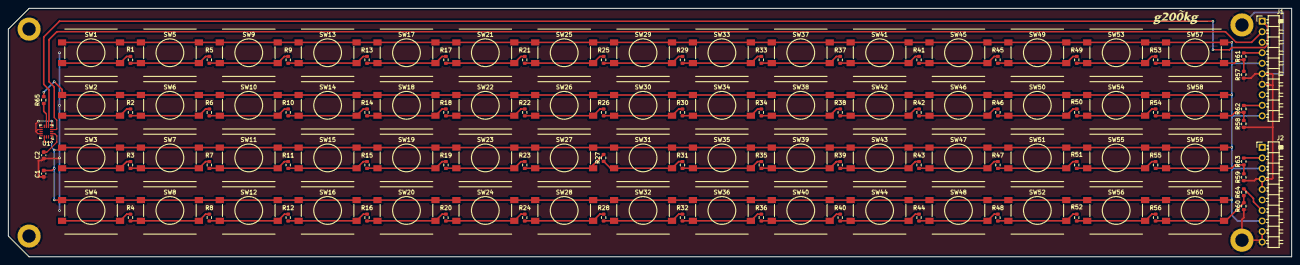
[picture p18: board PCB_Keys.kicad_pcb from above]

Board: 2 copper layers, 310.0 x 60.0 mm, 135 parts (0 on the bottom side), 70 nets.
