g200kg/multiribbon/Arduino/neopixel_test/neopixel_test.ino

#include <Adafruit_NeoPixel.h>

#define LED_PIN RGB_BUILTIN  // Define the pin for the built-in RGB LED
#define NUM_PIXELS 1         // Number of WS2812 LEDs

Adafruit_NeoPixel pixels(NUM_PIXELS, LED_PIN, NEO_GRB + NEO_KHZ800);

void setup() {
  pinMode(PIN_RGB_EN, OUTPUT); // Set up the power pin
  digitalWrite(PIN_RGB_EN, HIGH); //Turn on power to the LED
  pixels.begin();  // Initialize the NeoPixel library
}

void loop() {
    // Transition from Red to Green
  for (int i = 0; i <= 255; i++) {
    pixels.setPixelColor(0, pixels.Color(255 - i, i, 0));  // Red decreases, Green increases
    pixels.show();
    delay(10);  // Adjust delay for smoothness
  }

  // Transition from Green to Blue
  for (int i = 0; i <= 255; i++) {
    pixels.setPixelColor(0, pixels.Color(0, 255 - i, i));  // Green decreases, Blue increases
    pixels.show();
    delay(10);  // Adjust delay for smoothness
  }

  // Transition from Blue to Red
  for (int i = 0; i <= 255; i++) {
    pixels.setPixelColor(0, pixels.Color(i, 0, 255 - i));  // Blue decreases, Red increases
    pixels.show();
    delay(10);  // Adjust delay for smoothness
  }
}
