g200kg/multiribbon/(commit log)

2025-05-15 add blender files
    [Case_2_bottom.stl, Case_3_bottom.stl, Case_3_top.stl]
2025-05-18 add pcb data
    [PCB-B_Cu.gbl, PCB-B_Mask.gbs, PCB-B_Paste.gbp, PCB-B_SilkS.gbo, PCB-Edge_Cuts.gm1, PCB-F_Cu.gtl, PCB-F_Mask.gts, PCB-F_Paste.gtp]
2025-05-18 Revert "add pcb data"
    This reverts commit 672ffdb4691e8e0b232305007696bea88e0432db.
    [PCB-B_Cu.gbl, PCB-B_Mask.gbs, PCB-B_Paste.gbp, PCB-B_SilkS.gbo, PCB-Edge_Cuts.gm1, PCB-F_Cu.gtl, PCB-F_Mask.gts, PCB-F_Paste.gtp]
2025-05-23 add arduino files
    [PCB.sch, Quantize.xlsx]
